luishmcmoreno/toy-bracket-replacement/docs/reference-photos/01-top-view-caliper-width-43.27mm.jpg

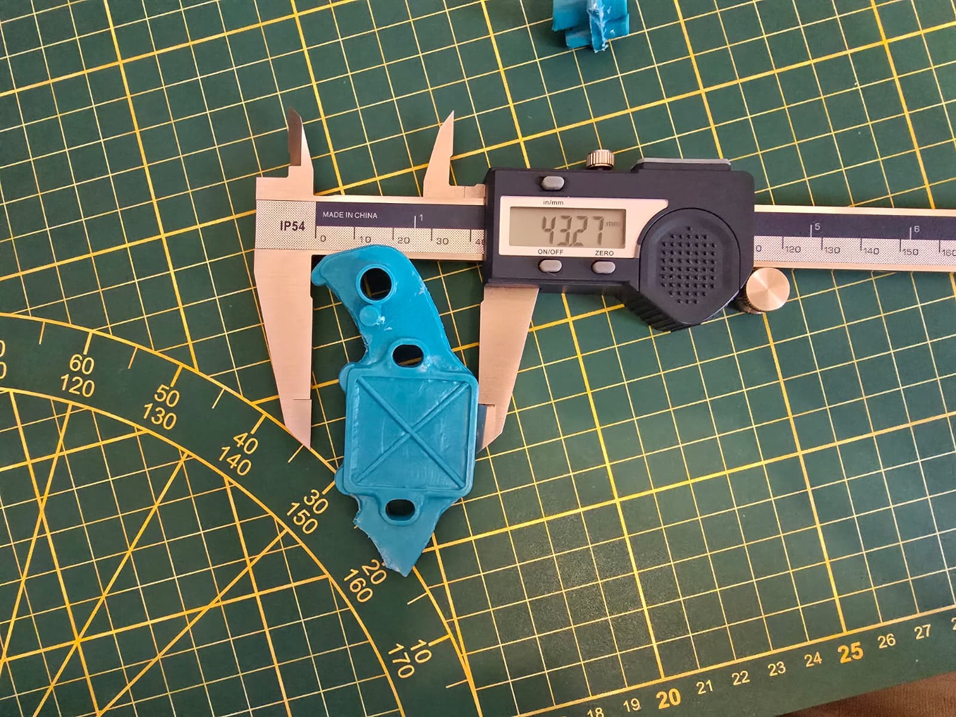
docs/reference-photos/01-top-view-caliper-width-43.27mm.jpg
