luishmcmoreno/toy-bracket-replacement/docs/reference-photos/02-oval-slots-inner-edges-34.27mm.jpg

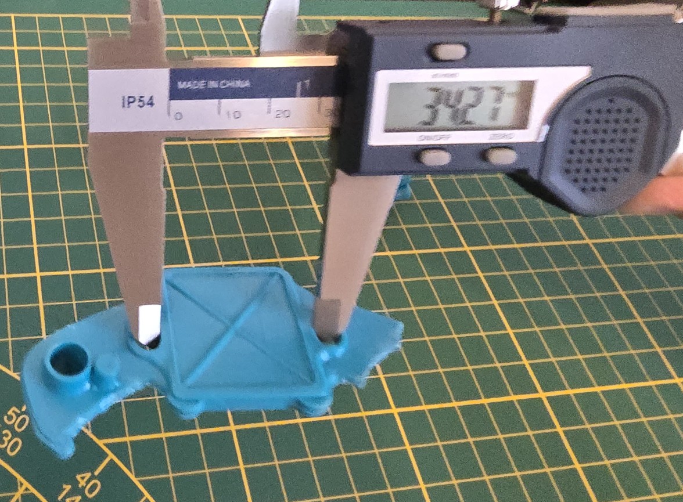
docs/reference-photos/02-oval-slots-inner-edges-34.27mm.jpg
