luishmcmoreno/toy-bracket-replacement/docs/reference-photos/03-reading-20.31mm.jpg

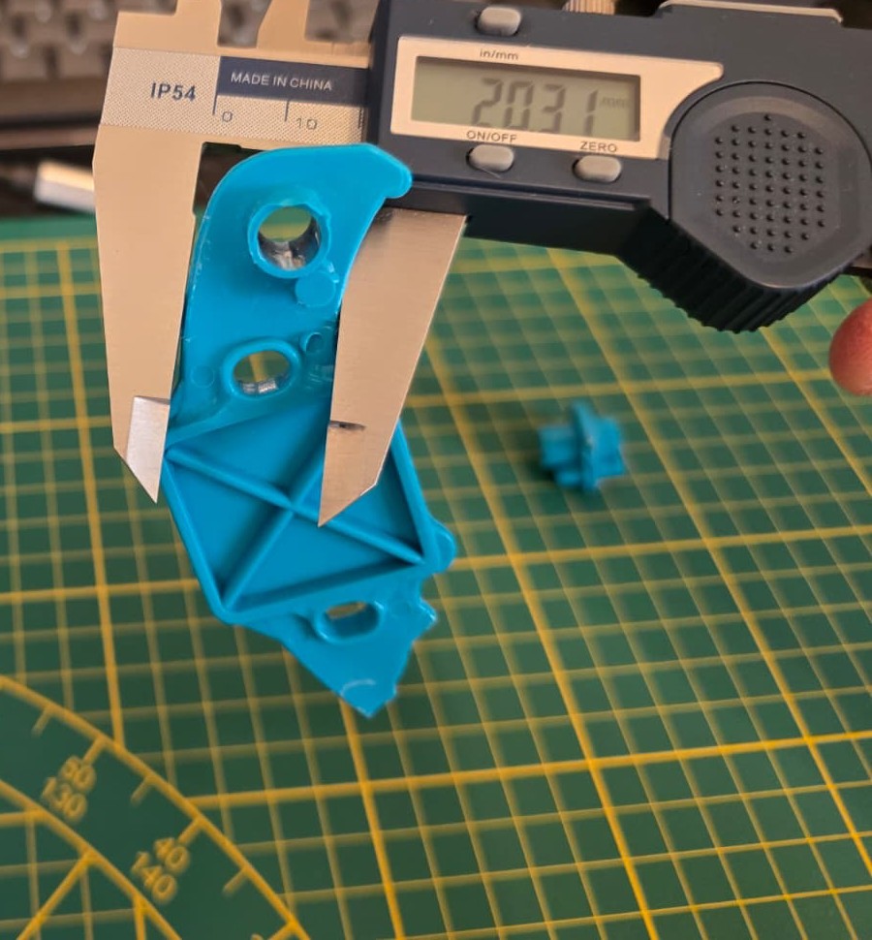
docs/reference-photos/03-reading-20.31mm.jpg
