luishmcmoreno/toy-bracket-replacement/docs/reference-photos/04-reading-20.32mm.jpg

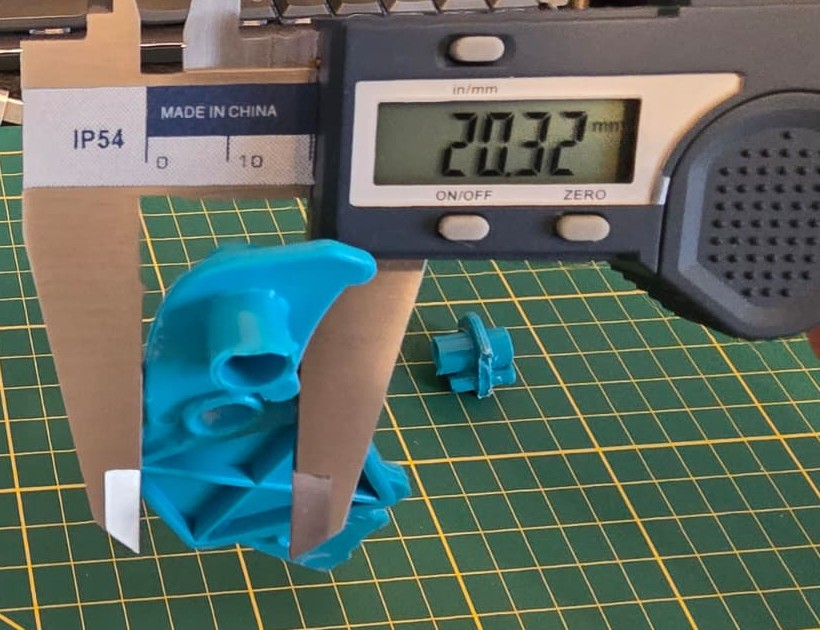
docs/reference-photos/04-reading-20.32mm.jpg
