luishmcmoreno/toy-bracket-replacement/docs/reference-photos/05-web-thickness-3.06mm.jpg

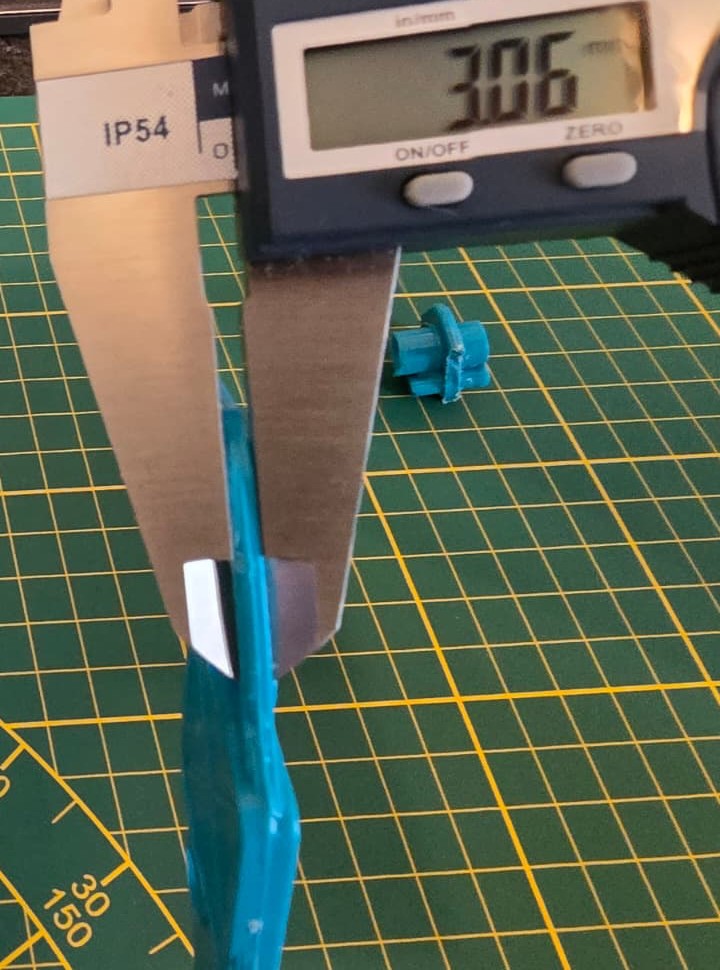
docs/reference-photos/05-web-thickness-3.06mm.jpg
