luishmcmoreno/toy-bracket-replacement/docs/reference-photos/06-face-b-ribs-tube-peg.jpg

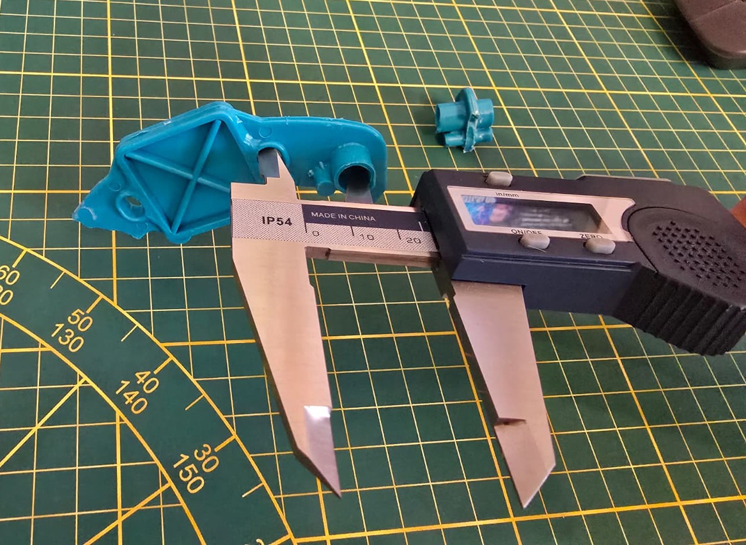
docs/reference-photos/06-face-b-ribs-tube-peg.jpg
