luishmcmoreno/toy-bracket-replacement/docs/reference-photos/07-oval-to-tube-14.15mm.jpg

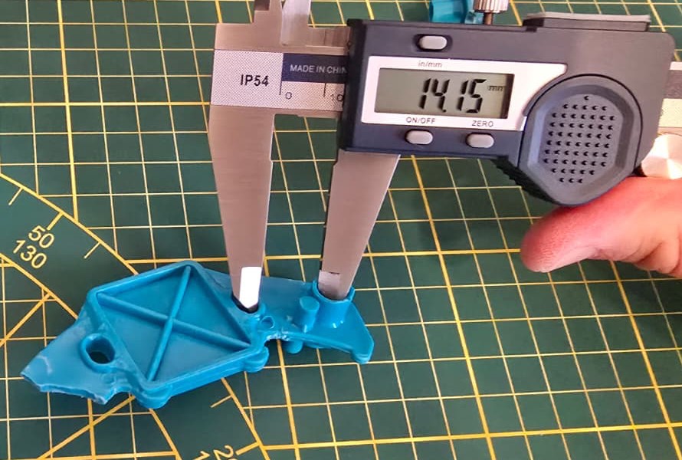
docs/reference-photos/07-oval-to-tube-14.15mm.jpg
