luishmcmoreno/toy-bracket-replacement/docs/reference-photos/08-oval-slots-40.37mm.jpg

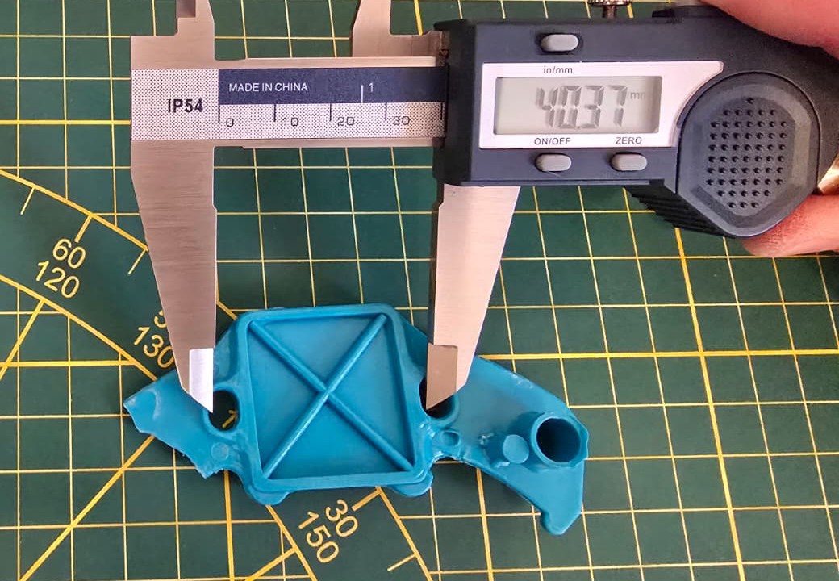
docs/reference-photos/08-oval-slots-40.37mm.jpg
