luishmcmoreno/toy-bracket-replacement/docs/reference-photos/09-thickness-5.91mm.jpg

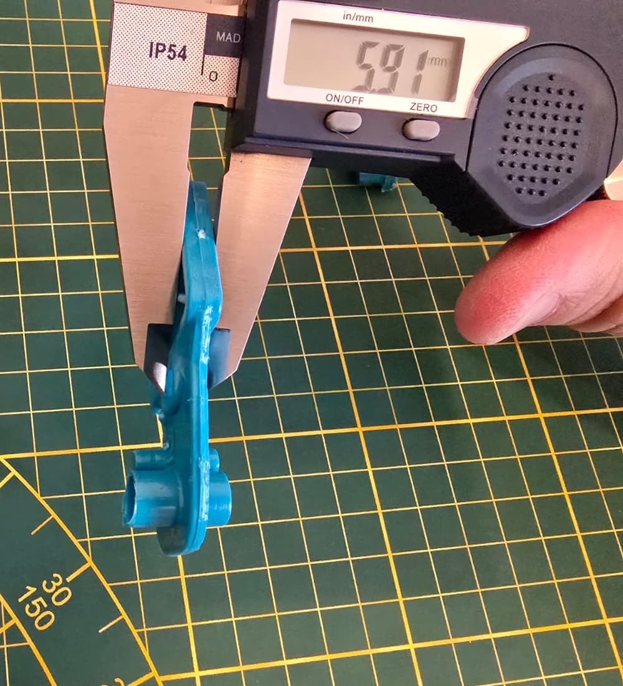
docs/reference-photos/09-thickness-5.91mm.jpg
