luishmcmoreno/toy-bracket-replacement/docs/reference-photos/10-top-view-on-mat-origin.jpg

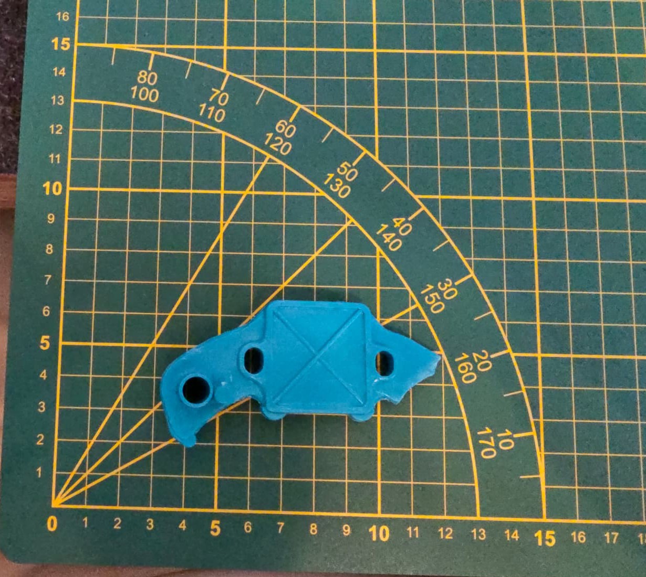
docs/reference-photos/10-top-view-on-mat-origin.jpg
