luishmcmoreno/toy-bracket-replacement/docs/reference-photos/11-face-a-and-broken-fragment.jpg

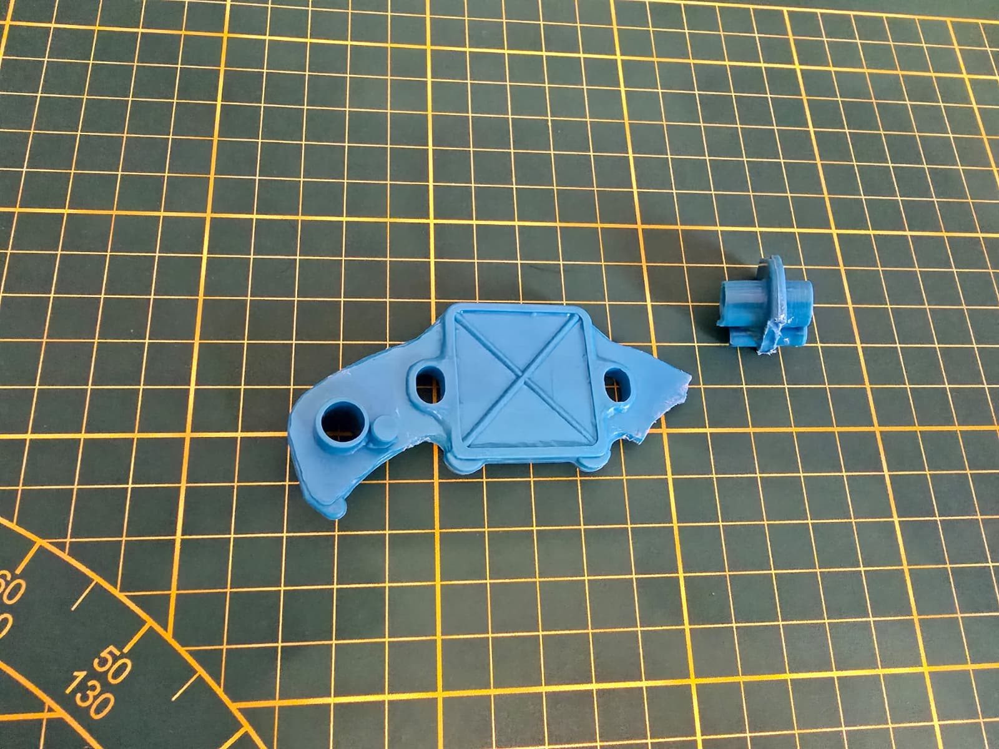
docs/reference-photos/11-face-a-and-broken-fragment.jpg
