luishmcmoreno/toy-bracket-replacement/docs/reference-photos/12-fragment-held-in-place-full-shape.jpg

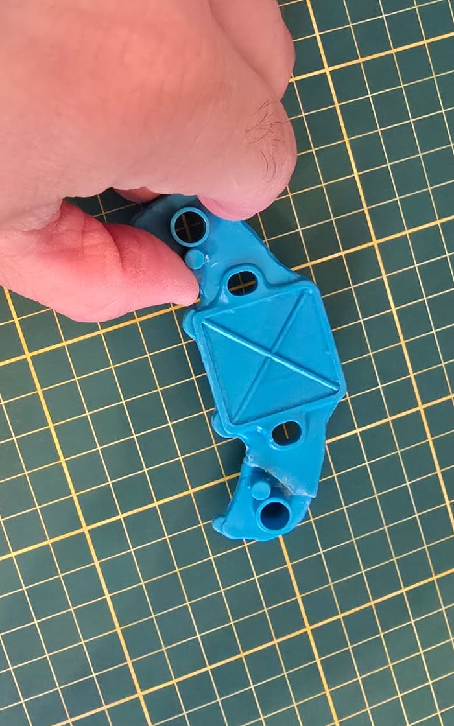
docs/reference-photos/12-fragment-held-in-place-full-shape.jpg
