luishmcmoreno/toy-bracket-replacement/docs/reference-photos/13-tube-outside-diameter-9.83mm.jpg

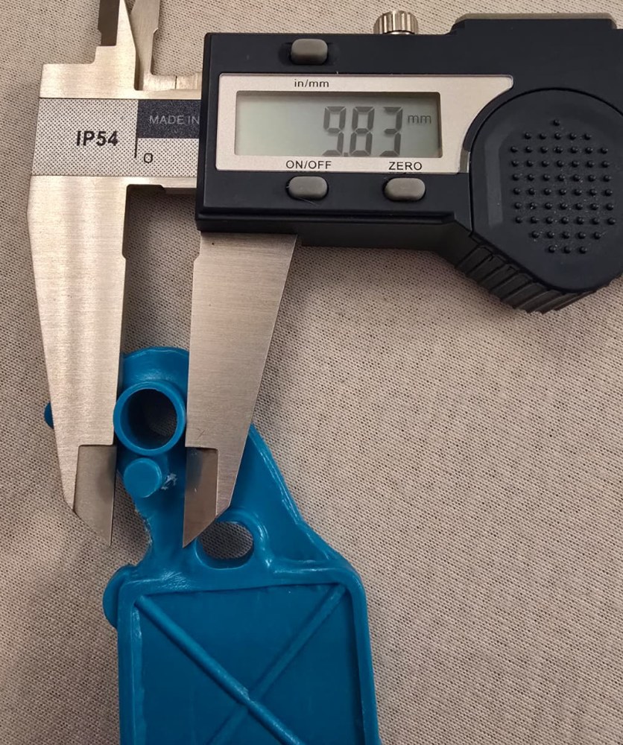
docs/reference-photos/13-tube-outside-diameter-9.83mm.jpg
