luishmcmoreno/toy-bracket-replacement/docs/reference-photos/14-tube-and-pin-outside-span-15.30mm.jpg

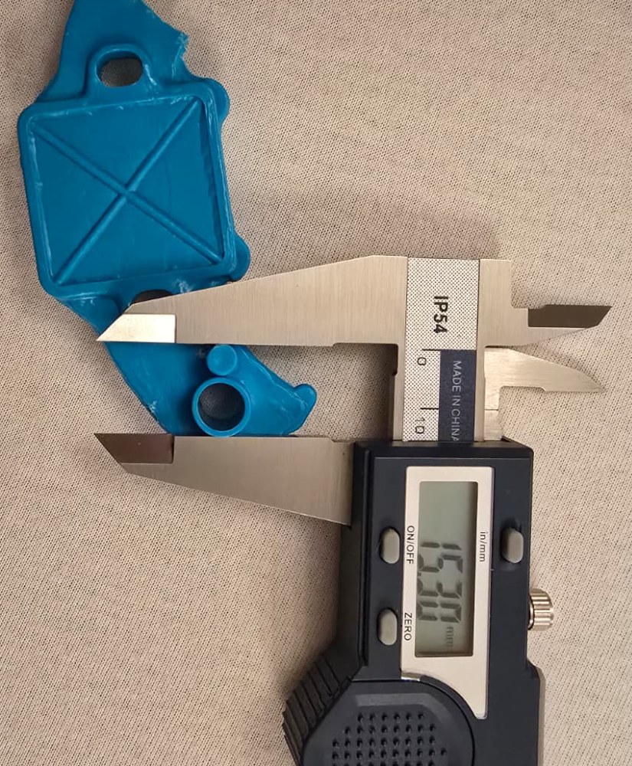
docs/reference-photos/14-tube-and-pin-outside-span-15.30mm.jpg
