luishmcmoreno/toy-bracket-replacement/docs/reference-photos/15-pin-diameter-4.92mm.jpg

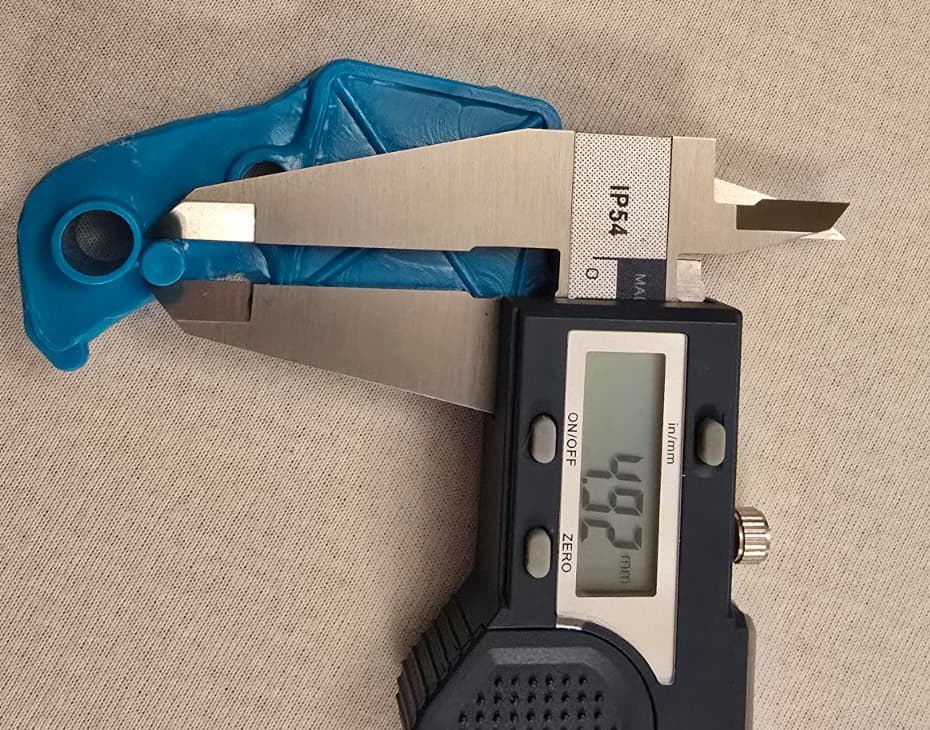
docs/reference-photos/15-pin-diameter-4.92mm.jpg
