luishmcmoreno/toy-bracket-replacement/docs/reference-photos/16-oval-to-bore-face-b-12.84mm.jpg

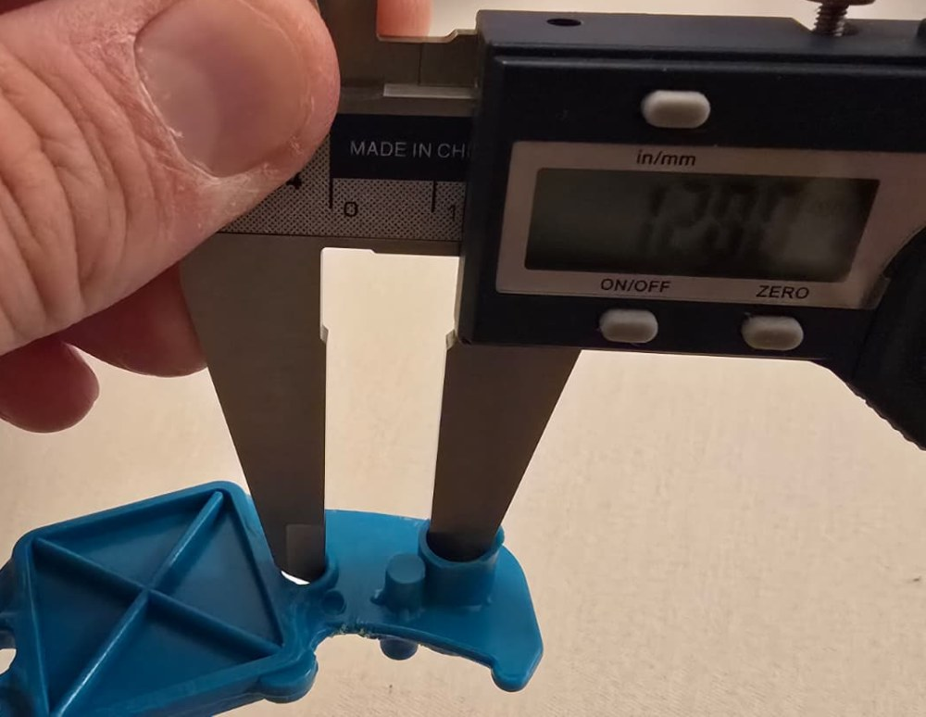
docs/reference-photos/16-oval-to-bore-face-b-12.84mm.jpg
