luishmcmoreno/toy-bracket-replacement/docs/reference-photos/17-tube-bore-inside-jaws-7.67mm.jpg

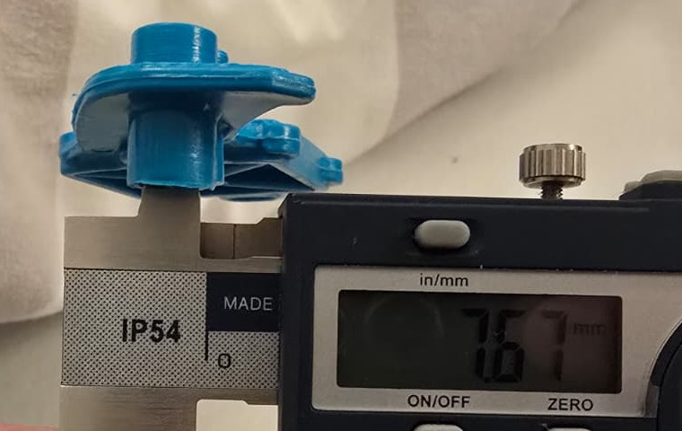
docs/reference-photos/17-tube-bore-inside-jaws-7.67mm.jpg
