luishmcmoreno/toy-bracket-replacement/docs/reference-photos/18-tube-wall-0.96mm.jpg

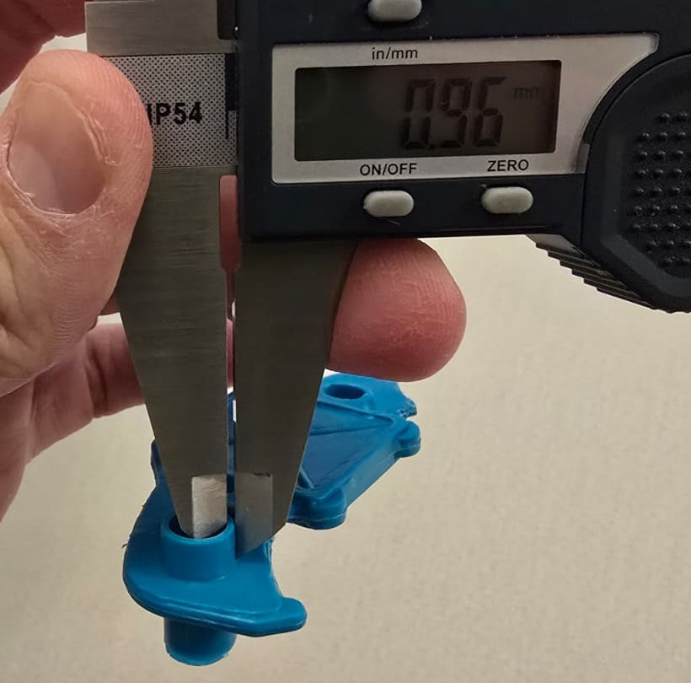
docs/reference-photos/18-tube-wall-0.96mm.jpg
