luishmcmoreno/toy-bracket-replacement/docs/reference-photos/19-bore-to-pin-6.04mm.jpg

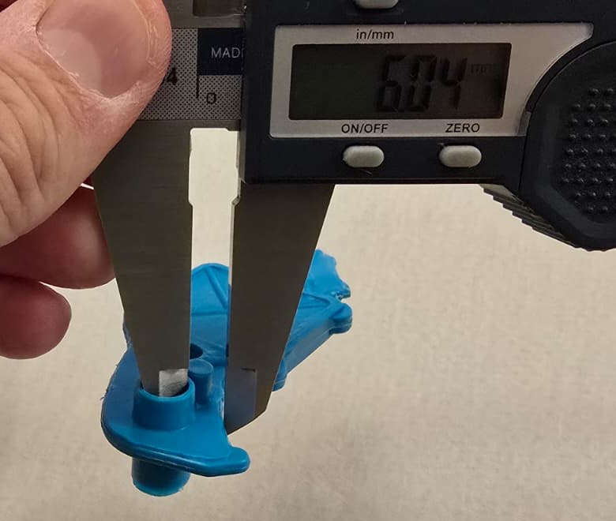
docs/reference-photos/19-bore-to-pin-6.04mm.jpg
