luishmcmoreno/toy-bracket-replacement/docs/reference-photos/20-fit-template-on-original.jpg

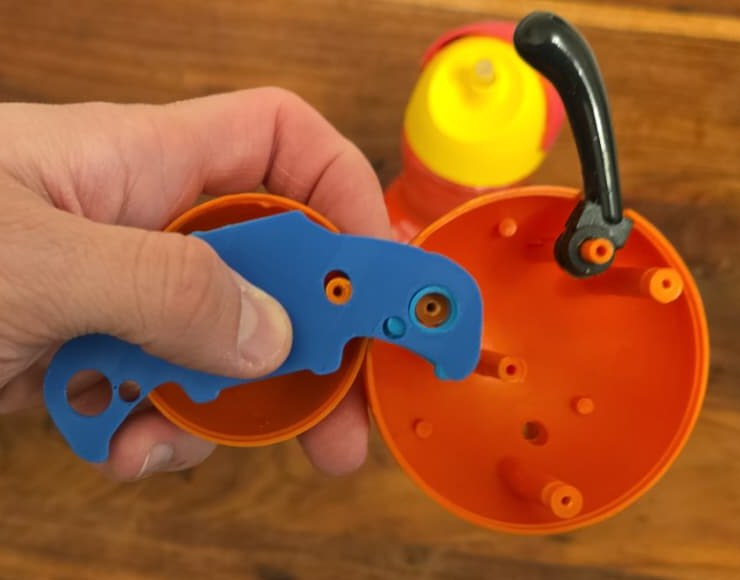
docs/reference-photos/20-fit-template-on-original.jpg
