luishmcmoreno/toy-bracket-replacement/stl/toy_bracket.stl

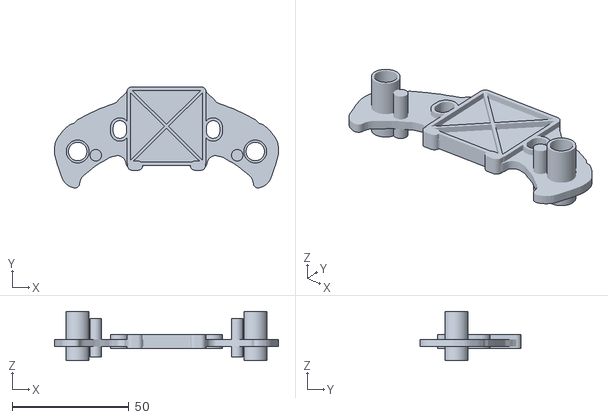
[picture p25: CAD file, 2026-10-21]
stl/toy_bracket.stl
96.1 x 43.3 x 21.1
