luishmcmoreno/toy-bracket-replacement/stl/toy_bracket_fit_template.stl

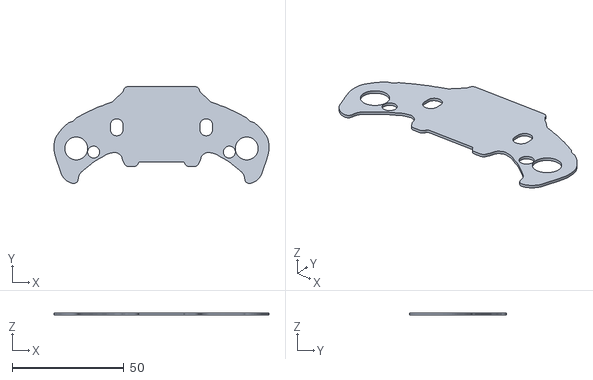
[picture p26: CAD file, 2026-10-21]
stl/toy_bracket_fit_template.stl
96.1 x 43.3 x 1.00
