luishmcmoreno/toy-bracket-replacement/src/arm_outline.scad

// GENERATED by tools/trace_outline.py - do not edit by hand.
// Outline of ONE intact arm (hook + tube boss area) in the part frame, millimetres.
// Origin: midpoint between the two oval slots. +u (x) towards this arm, -v (y) towards the hook.
// Source photo: docs/reference-photos/01-top-view-caliper-width-43.27mm.jpg; scale 0.9763, hook compression 0.9281.
arm_outline_points = [
  [16.384, 16.937],
  [18.373, 14.696],
  [19.761, 13.552],
  [21.406, 11.805],
  [21.875, 11.432],
  [22.410, 11.162],
  [24.690, 10.420],
  [26.329, 9.678],
  [28.615, 8.955],
  [30.766, 7.892],
  [32.970, 6.945],
  [38.257, 4.113],
  [39.471, 2.797],
  [40.013, 2.544],
  [41.162, 2.204],
  [41.686, 1.913],
  [43.527, 0.376],
  [44.369, -0.478],
  [46.204, -2.851],
  [46.879, -3.843],
  [47.434, -4.906],
  [47.798, -6.047],
  [47.979, -7.233],
  [48.054, -8.430],
  [48.036, -10.230],
  [47.865, -11.415],
  [46.725, -15.457],
  [46.103, -17.027],
  [45.043, -20.219],
  [44.639, -21.268],
  [44.376, -21.768],
  [43.702, -22.687],
  [42.892, -23.508],
  [42.444, -23.879],
  [41.437, -24.479],
  [40.330, -24.908],
  [39.749, -25.044],
  [39.152, -25.083],
  [38.563, -24.983],
  [38.035, -24.724],
  [37.624, -24.322],
  [37.367, -23.821],
  [37.049, -22.178],
  [36.664, -21.127],
  [36.002, -20.201],
  [35.163, -19.405],
  [32.419, -17.243],
  [30.638, -15.753],
  [28.635, -14.452],
  [26.508, -13.344],
  [24.482, -12.063],
  [23.347, -11.683],
  [21.003, -11.186],
  [20.408, -11.247],
  [19.840, -11.441],
  [19.304, -11.709],
  [18.800, -12.035],
  [18.347, -12.426],
  [17.983, -12.901],
  [17.741, -13.449],
  [17.206, -15.165],
  [16.616, -16.155],
  [13.109, -16.155],
  [13.109, 16.937]
];
