luishmcmoreno/toy-bracket-replacement/(commit log)

2026-10-21 feat: parametric OpenSCAD model of the toy bracket (v1) with photos, measurements and agent docs
    [arm_outline.scad, toy_bracket.scad, toy_bracket.stl, toy_bracket_fit_template.stl]
2026-10-21 feat: v2 with measured tube and pin diameters and corrected pin position from the fit check
    [toy_bracket.scad, toy_bracket.stl, toy_bracket_fit_template.stl]
